mathan416/Quarkwave/QuarkWave MIDI/docs/images/onboard/board-overview.jpg

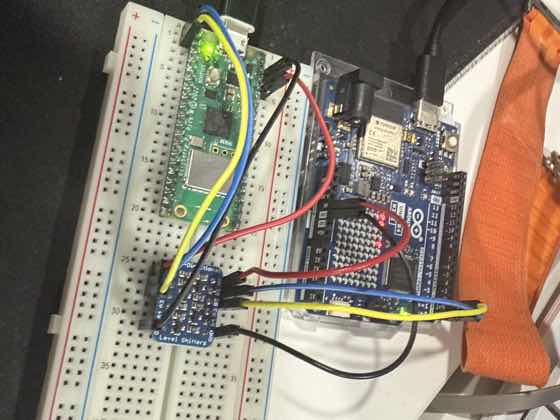
QuarkWave MIDI/docs/images/onboard/board-overview.jpg
