mathan416/Quarkwave/QuarkWave MIDI/docs/images/onboard/explore-simulated.jpg

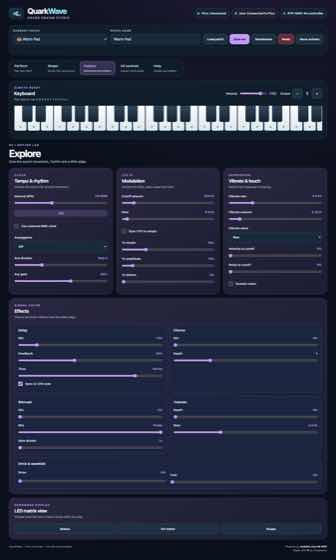
QuarkWave MIDI/docs/images/onboard/explore-simulated.jpg
