mathan416/Quarkwave/QuarkWave MIDI/docs/images/onboard/headphone-amplifier-photo.jpg

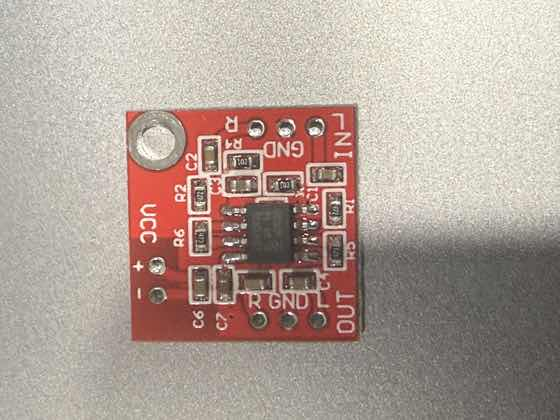
QuarkWave MIDI/docs/images/onboard/headphone-amplifier-photo.jpg
