mathan416/Quarkwave/QuarkWave MIDI/docs/images/onboard/help-simulated.jpg

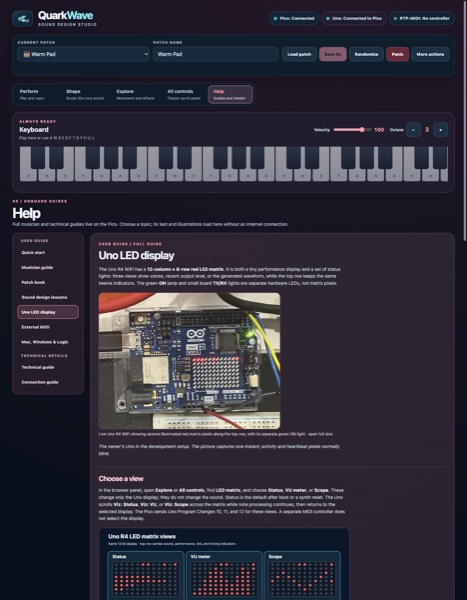
QuarkWave MIDI/docs/images/onboard/help-simulated.jpg
