mathan416/Quarkwave/QuarkWave MIDI/docs/images/onboard/save-as-simulated.jpg

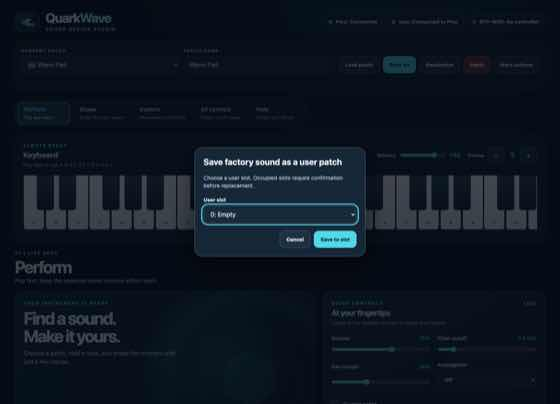
QuarkWave MIDI/docs/images/onboard/save-as-simulated.jpg
