mathan416/Quarkwave/QuarkWave MIDI/docs/images/onboard/shape-simulated.jpg

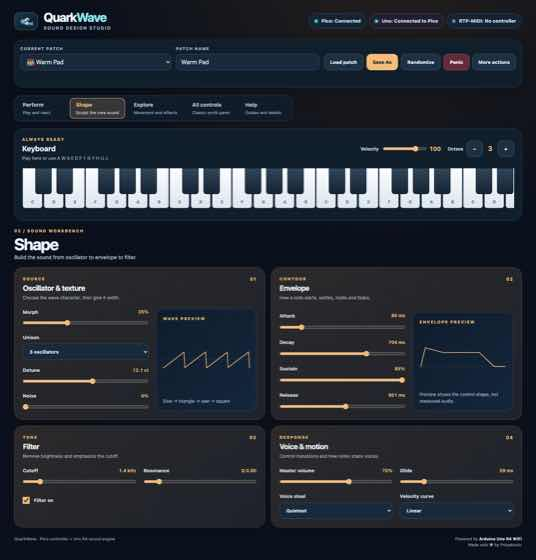
QuarkWave MIDI/docs/images/onboard/shape-simulated.jpg
