mathan416/Quarkwave/(commit log)

2026-09-23 Document Uno LED and audio timing diagnostic
2026-09-23 Restore nonblocking Uno LED mode scroll
2026-09-23 Refine Uno oscillator path and document remaining audio limit
    [QuarkWave_MIDI.ino]
2026-09-23 Move RTP-MIDI gateway to Pico and document standalone DIN path
2026-09-23 Release wireless notes and sustain on RTP disconnect
2026-09-23 Clarify Pico Uno connection and sound status
2026-09-23 Update Uno LED status indicators and guide
2026-09-23 Add isolated Uno USB audio experiment and driver fix
    [UsbAudioCapture.h, build.py, upload.py]
2026-09-24 Serve complete illustrated guides in Pico Help center
